magfest/MAGWest-2017-Swadges/path5070.png

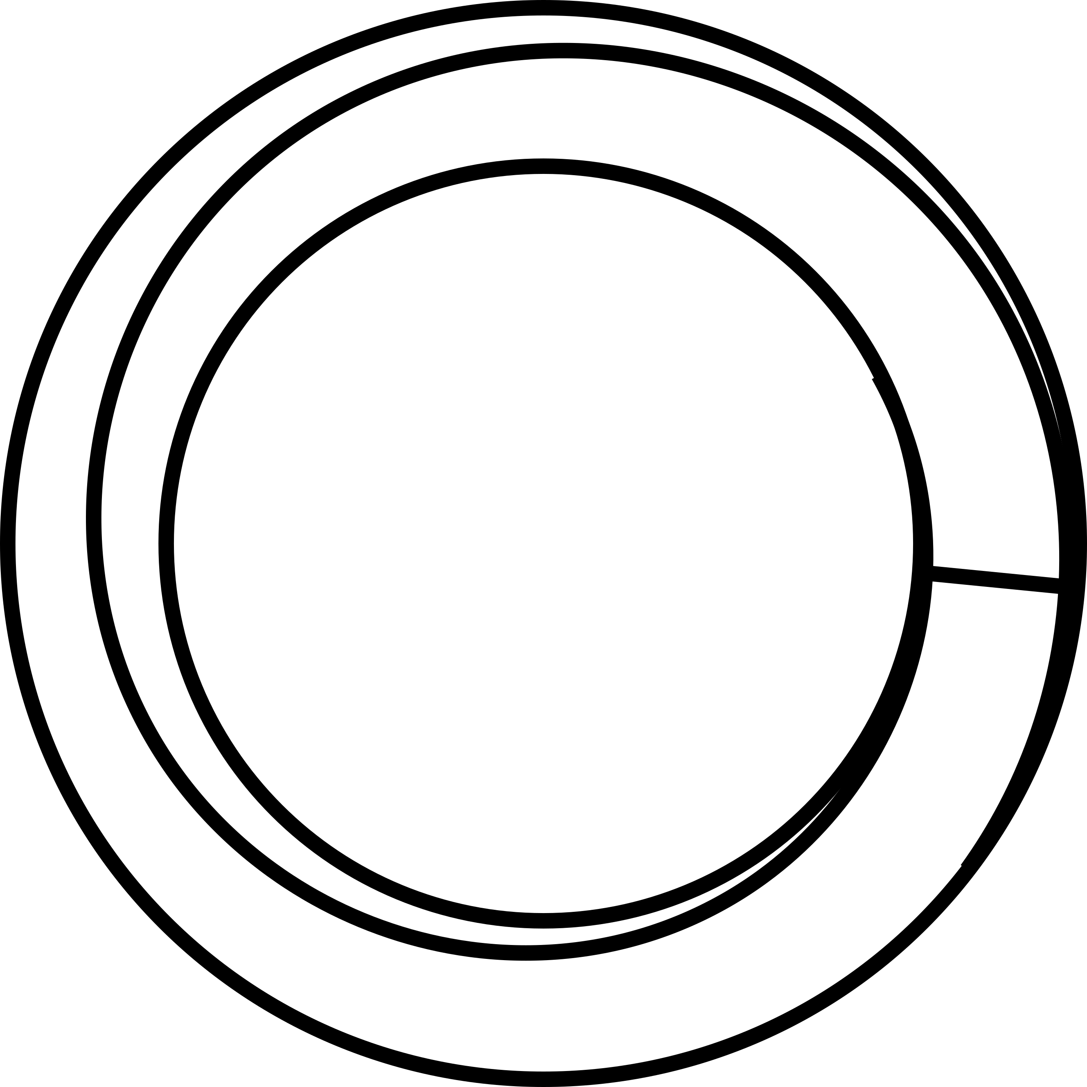
path5070.png
