magfest/MAGWest-2017-Swadges/spiral.png

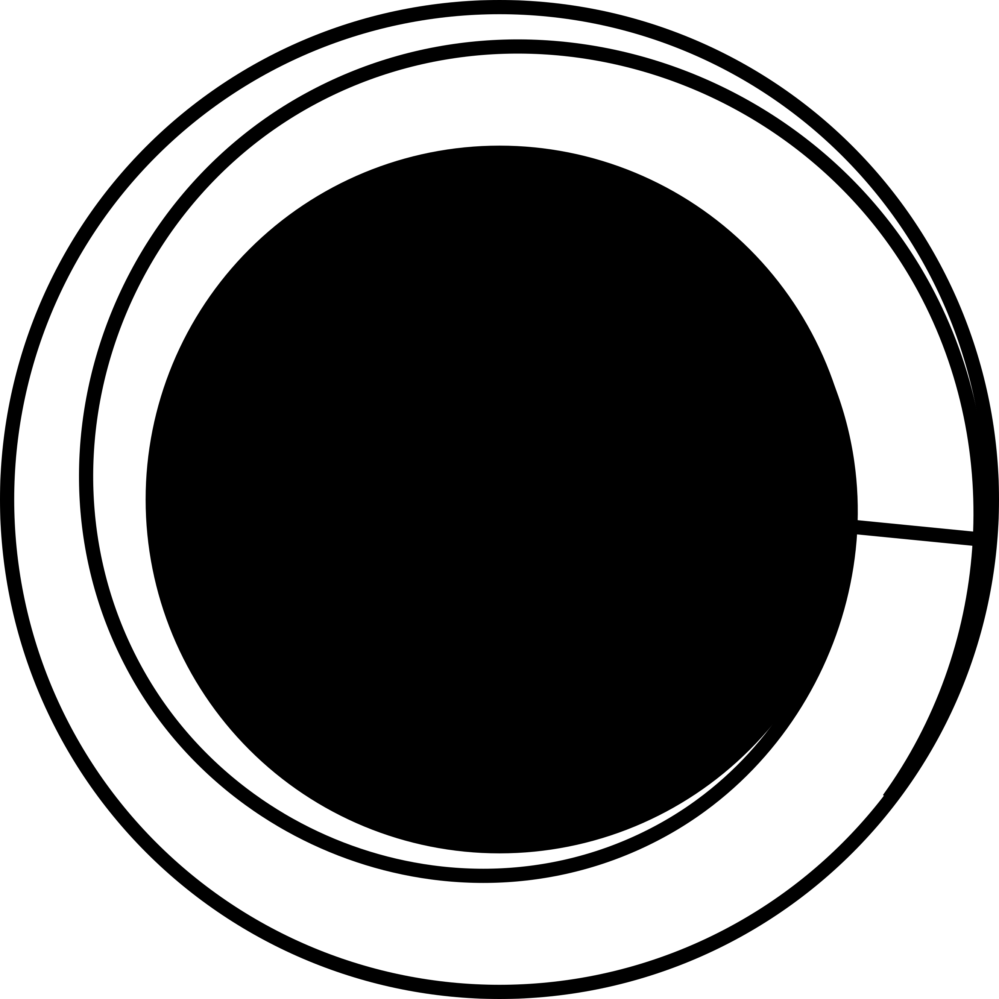
spiral.png
