magfest/MAGWest-2017-Swadges/(list of files, drawings)

Other design files:
magwadges17.dsn
