magfest/MAGWest-2017-Swadges/magwadges17.kicad_pcb

## KiCad design magwadges17.kicad_pcb (2017-08-10)

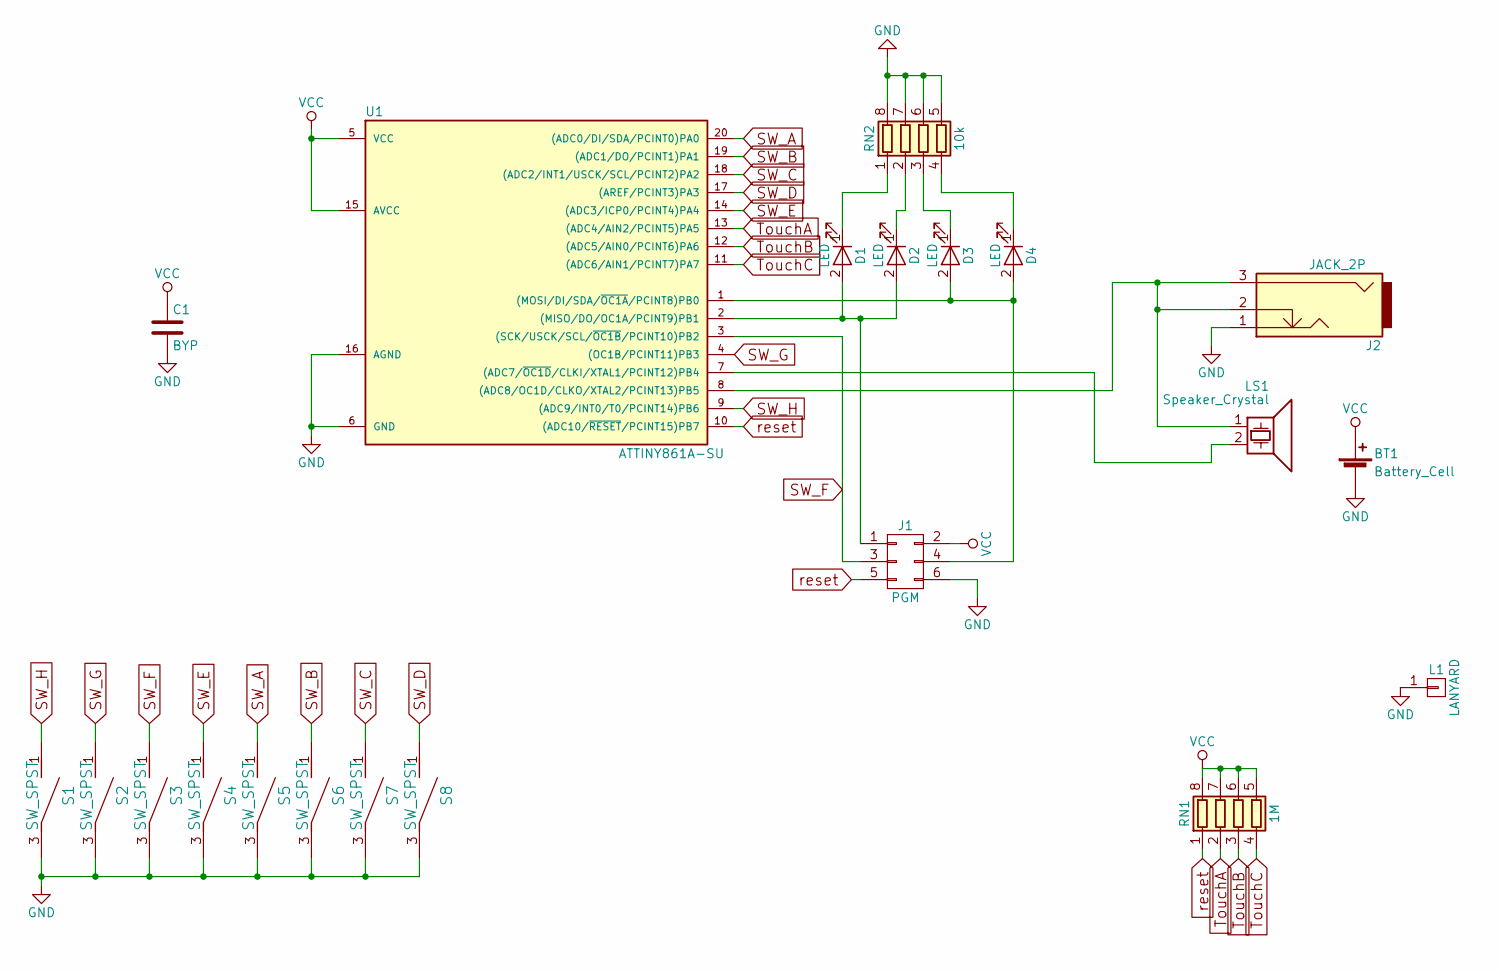
[picture p3: schematic magwadges17.sch]

Parts:
BT1: Battery_Cell; S8211-45R
C1: BYP; SM0805
D1, D2, D3, D4: LED; SM0805
J1: PGM; Pin_Header_Straight_2x03_Pitch2.54mm_SMD
J2: JACK_2P; SJ-252X-SMT
L1: LANYARD; 1pin
LS1: Speaker_Crystal; PS1740P02CE
RN1: 1M; NETWORK1206
RN2: 10k; NETWORK1206
S1, S2, S3, S4, S5, S6, S7, S8: SW_SPST; PTS645
U1: ATTINY861A-SU; SOIC-20W_7.5x12.8mm_Pitch1.27mm

Connections:
GND: BT1.2 (-), C1.2, J1.6, J2.1, L1.1, RN2.5 (R4.2), RN2.6 (R3.2), RN2.7 (R2.2), RN2.8 (R1.2), S1.3, S2.3, S3.3, S4.3, S5.3, S6.3, S7.3, S8.3, U1.6 (GND), U1.16 (AGND)
unnamed: D1.1 (K), RN2.1 (R1.1)
unnamed: D1.2 (A), D2.2 (A), J1.1, U1.2 ((MISO/DO/OC1A/PCINT9)PB1)
unnamed: D2.1 (K), RN2.2 (R2.1)
unnamed: D3.1 (K), RN2.3 (R3.1)
unnamed: D3.2 (A), D4.2 (A), J1.4, U1.1 ((MOSI/DI/SDA/~OC1A~/PCINT8)PB0)
unnamed: D4.1 (K), RN2.4 (R4.1)
unnamed: J2.2, J2.3, LS1.1, U1.8 ((ADC8/OC1D/CLKO/XTAL2/PCINT13)PB5)
unnamed: LS1.2, U1.7 ((ADC7/~OC1D~/CLKI/XTAL1/PCINT12)PB4)
SW_A: S5.1, U1.20 ((ADC0/DI/SDA/PCINT0)PA0)
SW_B: S6.1, U1.19 ((ADC1/DO/PCINT1)PA1)
SW_C: S7.1, U1.18 ((ADC2/INT1/USCK/SCL/PCINT2)PA2)
SW_D: S8.1, U1.17 ((AREF/PCINT3)PA3)
SW_E: S4.1, U1.14 ((ADC3/ICP0/PCINT4)PA4)
SW_F: J1.3, S3.1, U1.3 ((SCK/USCK/SCL/~OC1B~/PCINT10)PB2)
SW_G: S2.1, U1.4 ((OC1B/PCINT11)PB3)
SW_H: S1.1, U1.9 ((ADC9/INT0/T0/PCINT14)PB6)
TouchA: RN1.2 (R2.1), U1.13 ((ADC4/AIN2/PCINT5)PA5)
TouchB: RN1.3 (R3.1), U1.12 ((ADC5/AIN0/PCINT6)PA6)
TouchC: RN1.4 (R4.1), U1.11 ((ADC6/AIN1/PCINT7)PA7)
VCC: BT1.1 (+), C1.1, J1.2, RN1.5 (R4.2), RN1.6 (R3.2), RN1.7 (R2.2), RN1.8 (R1.2), U1.5 (VCC), U1.15 (AVCC)
reset: J1.5, RN1.1 (R1.1), U1.10 ((ADC10/~RESET~/PCINT15)PB7)

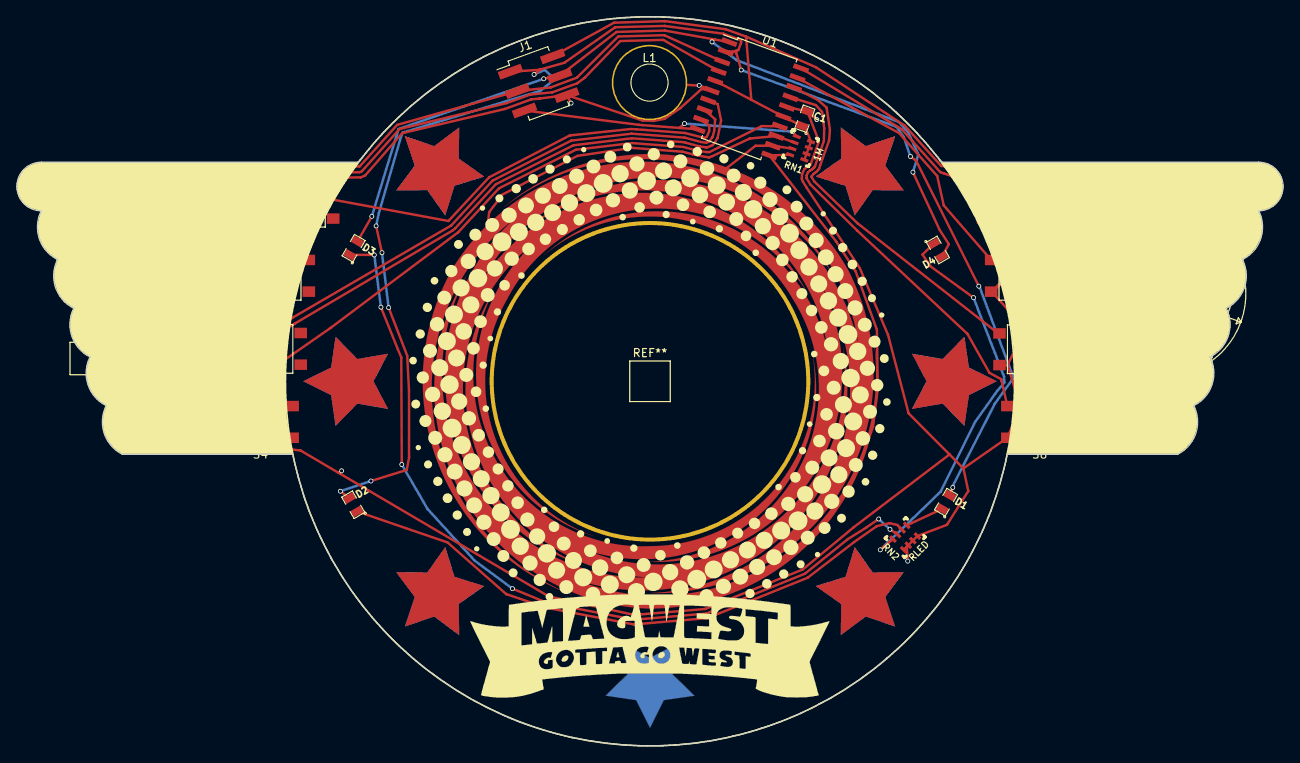
[picture p4: board magwadges17.kicad_pcb from above]

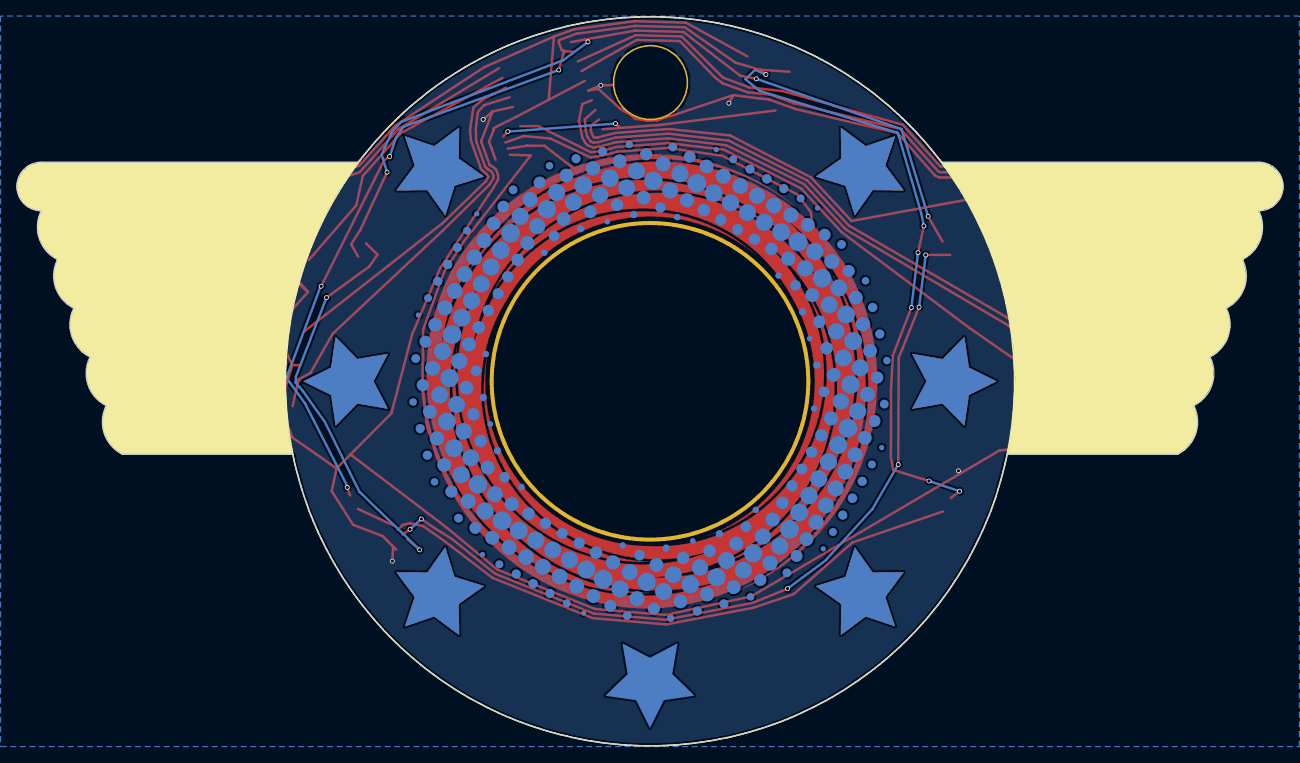
[picture p5: board magwadges17.kicad_pcb from below]

Board: 2 copper layers, 156.0 x 89.8 mm, 47 parts (14 on the bottom side), 22 nets.

Other parts of the board:
G0, G1, G2, G4, G4#2, G5, G6, G7, G8, G9, G11, G12, G13: LOGO; test_star4
G14, G15, G16, G18, G18#2, G19, G20, G21, G22, G23, G25, G26, G27: LOGO; test_star4_copper
