magfest/MAGWest-2017-Swadges/testfirmware/touch.c

#include <avr/io.h>
#include <avr/interrupt.h>
#include "touch.h"

volatile unsigned char TimerAtTrigger;
uint8_t calced_angle;
int8_t calced_amplitude;

//";		push r0 \n"
//";		in	r0, 0x3f\n" //Backup SREG
//";		pop r0 \n"
//";		out 0x3f, r0\n"


#ifdef FAST_TOUCH_ISR

ISR( PCINT_vect, ISR_NAKED )
{
	asm volatile( "\n"
"		push r24 \n"
"		in	r24, %[tcnt1]\n"
"		sts TimerAtTrigger, r24\n"
"		in  r24, %[gimsk]\n"
"		andi r24, ~(1<<5)\n"
"		out %[gimsk], r24\n"
"		pop r24 \n"
"		reti \n"
	: 
	: [tcnt1] "I" (_SFR_IO_ADDR(TCNT1)), [gimsk] "I" (_SFR_IO_ADDR(GIMSK))
	);
}
#else
ISR( PCINT_vect )
{
	TimerAtTrigger = TCNT1; //Interrupts only happen every other cycle anyway.
	//GIFR |= _BV(5);
	GIMSK &= ~_BV(5);     //Turn interrupt back off.
}
#endif



volatile uint8_t touchvals[3];
volatile uint8_t filt_touchvals[3];
uint8_t curtouch = 5;

void TouchNext()
{
	uint8_t k;
	if( curtouch == 5 )
	{
		touchvals[0] = k = TouchTest5();
		if( k > filt_touchvals[0] ) filt_touchvals[0]++;
		if( k < filt_touchvals[0] ) filt_touchvals[0]--;
		curtouch = 6;
	}
	else if( curtouch == 6 )
	{
		touchvals[1] = k = TouchTest6();
		if( k > filt_touchvals[1] ) filt_touchvals[1]++;
		if( k < filt_touchvals[1] ) filt_touchvals[1]--;
		curtouch = 7;
	}
	else
	{
		touchvals[2]  = k = TouchTest7();
		if( k > filt_touchvals[2] ) filt_touchvals[2]++;
		if( k < filt_touchvals[2] ) filt_touchvals[2]--;
		curtouch = 5;
	}
}




//This is a terrible version of TouchTest, an 8-bit version.

/*
unsigned char TouchTest( unsigned char pin, unsigned char mask )
{
	unsigned char i;
	unsigned char ret = 0;
	unsigned char initialt1;
	PCMSK0 = mask;		//Select interrupt
	GIFR  |= _BV(5);
	DDRA &= ~mask;		//Release the pin to float high.
	GIMSK |= _BV(5);		//Turn on PCINT0  ok, actually this is a bug in their documentation. BUT that's ok.
	PORTA |= mask;
	initialt1 = TCNT1;
	while( !(PINA & mask) );
	ret = TimerAtTrigger - initialt1;
	DDRA |=  mask;     //Lock the pin back low.
	PORTA &= ~mask;
	return ret;
}
*/

#ifndef USE_ASM_TOUCH

#define TTGEN(pin) \
uint8_t TouchTest##pin( ) \
{ \
	unsigned char ret = 0; \
	unsigned char initialt1; \
	PCMSK0 = _BV(pin);		/*Select interrupt*/ \
	GIFR  |= _BV(5);		/*Wipe out any pending flags*/ \
	DDRA &= ~_BV(pin);		/*Release the pin to float high. */ \
	GIMSK |= _BV(5);		/*Turn on PCINT0  ok, actually this is a bug in their documentation. BUT that's ok. */ \
	PORTA |= _BV(pin);		/*Enable weak pullup */ \
	initialt1 = TCNT1; sei(); \
	/*while( !(PINA & mask ) ); *//*XXX Tricky... bug in processor? SOMETIMES?  Can't use _BV(pin)! */ \
	while( !(PINA & _BV(pin)) ); \
	ret = TimerAtTrigger - initialt1; \
	DDRA |=  _BV(pin);     /*Lock the pin back low.*/ \
	PORTA &= ~_BV(pin); \
	return ret; \
}
TTGEN(5);
TTGEN(6);
TTGEN(7);

#endif





void CalcTouch()
{
	uint8_t maximumtouch = 0;
	uint8_t angle = 0;

	uint8_t s1 = (int8_t)filt_touchvals[0] - CAL_BASELINE;
	uint8_t s2 = (int8_t)filt_touchvals[1] - CAL_BASELINE;
	uint8_t s3 = (int8_t)filt_touchvals[2] - CAL_BASELINE;

	if( s1 < s2 && s1 < s3 )
	{
		//S1 is minimum (baseline)
		s2 -= s1;
		s3 -= s1;

		//Compare S2/S3
		if( s2 > s3 )
		{
			//S2 is max.
			maximumtouch = s2;
			angle = 30 + (30 * (int16_t)s3) / s2;   //Starts at 2 o'clock
		}
		else
		{
			//S3 is max.
			maximumtouch = s3;
			angle = 90 - (30 * (int16_t)s2) / s3;  //Starts around 4 o'clock.
		}
	}
	else if( s2 < s3 )
	{
		s1 -= s2;
		s3 -= s2;
		if( s1 > s3 )
		{
			maximumtouch = s1;
			angle = 150 - (30 * (int16_t)s3) / s1;
		}
		else
		{
			maximumtouch = s3;
			angle = 90 + (30 * (int16_t)s1) / s3;
		}

	}
	else
	{
		s2 -= s3;
		s1 -= s3;
		if( s1 > s2 )
		{
			maximumtouch = s1;
			angle = 150 + (30 * (int16_t)s2) / s1;
		}
		else
		{
			maximumtouch = s2;
			angle = 30 - (30 * (int16_t)s1) / s2;   //STARTS at 12 O'clock
		}
	}
	calced_angle = angle;
	calced_amplitude = maximumtouch;
}
