magfest/MAGWest-2017-Swadges/(commit log)

2017-07-28 Updated schematic
    [_saved_magwadges17.sch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]
2017-07-31 single layer in
    [magwadges17.kicad_pcb, magwadges17.sch]
2017-07-31 Fixed layout of battery holder and headphone jack
    [magwadges17.kicad_pcb]
2017-07-31 Update center spinner
    [magwadges17.kicad_pcb]
2017-07-31 Update wadges
    [magwadges17.kicad_pcb, magwadges17.sch]
2017-08-03 Update design
    [magwadges17.kicad_pcb, magwadges17.sch]
2017-08-04 Update with halftone
    [magwadges17.kicad_pcb]
2017-08-04 Update design with halftone, etc.
    [magwadges17.kicad_pcb]
2017-08-04 err apparently forgot tos ave acutal pcb
    [magwadges17.kicad_pcb]
2017-08-10 update plots rel
    [magwadges17.kicad_pcb]
2017-08-10 final plots as they were sent.
    [magwadges17.kicad_pcb]
2017-08-10 try this, as an alternative
    [magwadges17.kicad_pcb]
2017-08-10 Revert "final plots as they were sent."
    This reverts commit bfd323c62603574740bf4a4b772e69891fb19e77.
    [magwadges17.kicad_pcb]
2017-08-10 Update plots as sent.
    [magwadges17.kicad_pcb]
2017-08-21 Yay! Now operating with a budget of 0.7mA when idle.
